agkaminski/VGAtest/README.md

# VGA test

Proof of concept VGA 640x480@60Hz video adapter. Only 80x60 text mode is
supported, up to 4 fonts (8x8 font, 256 char each.

## PCB



## Example video output
