agkaminski/VGAtest/schematic.pdf

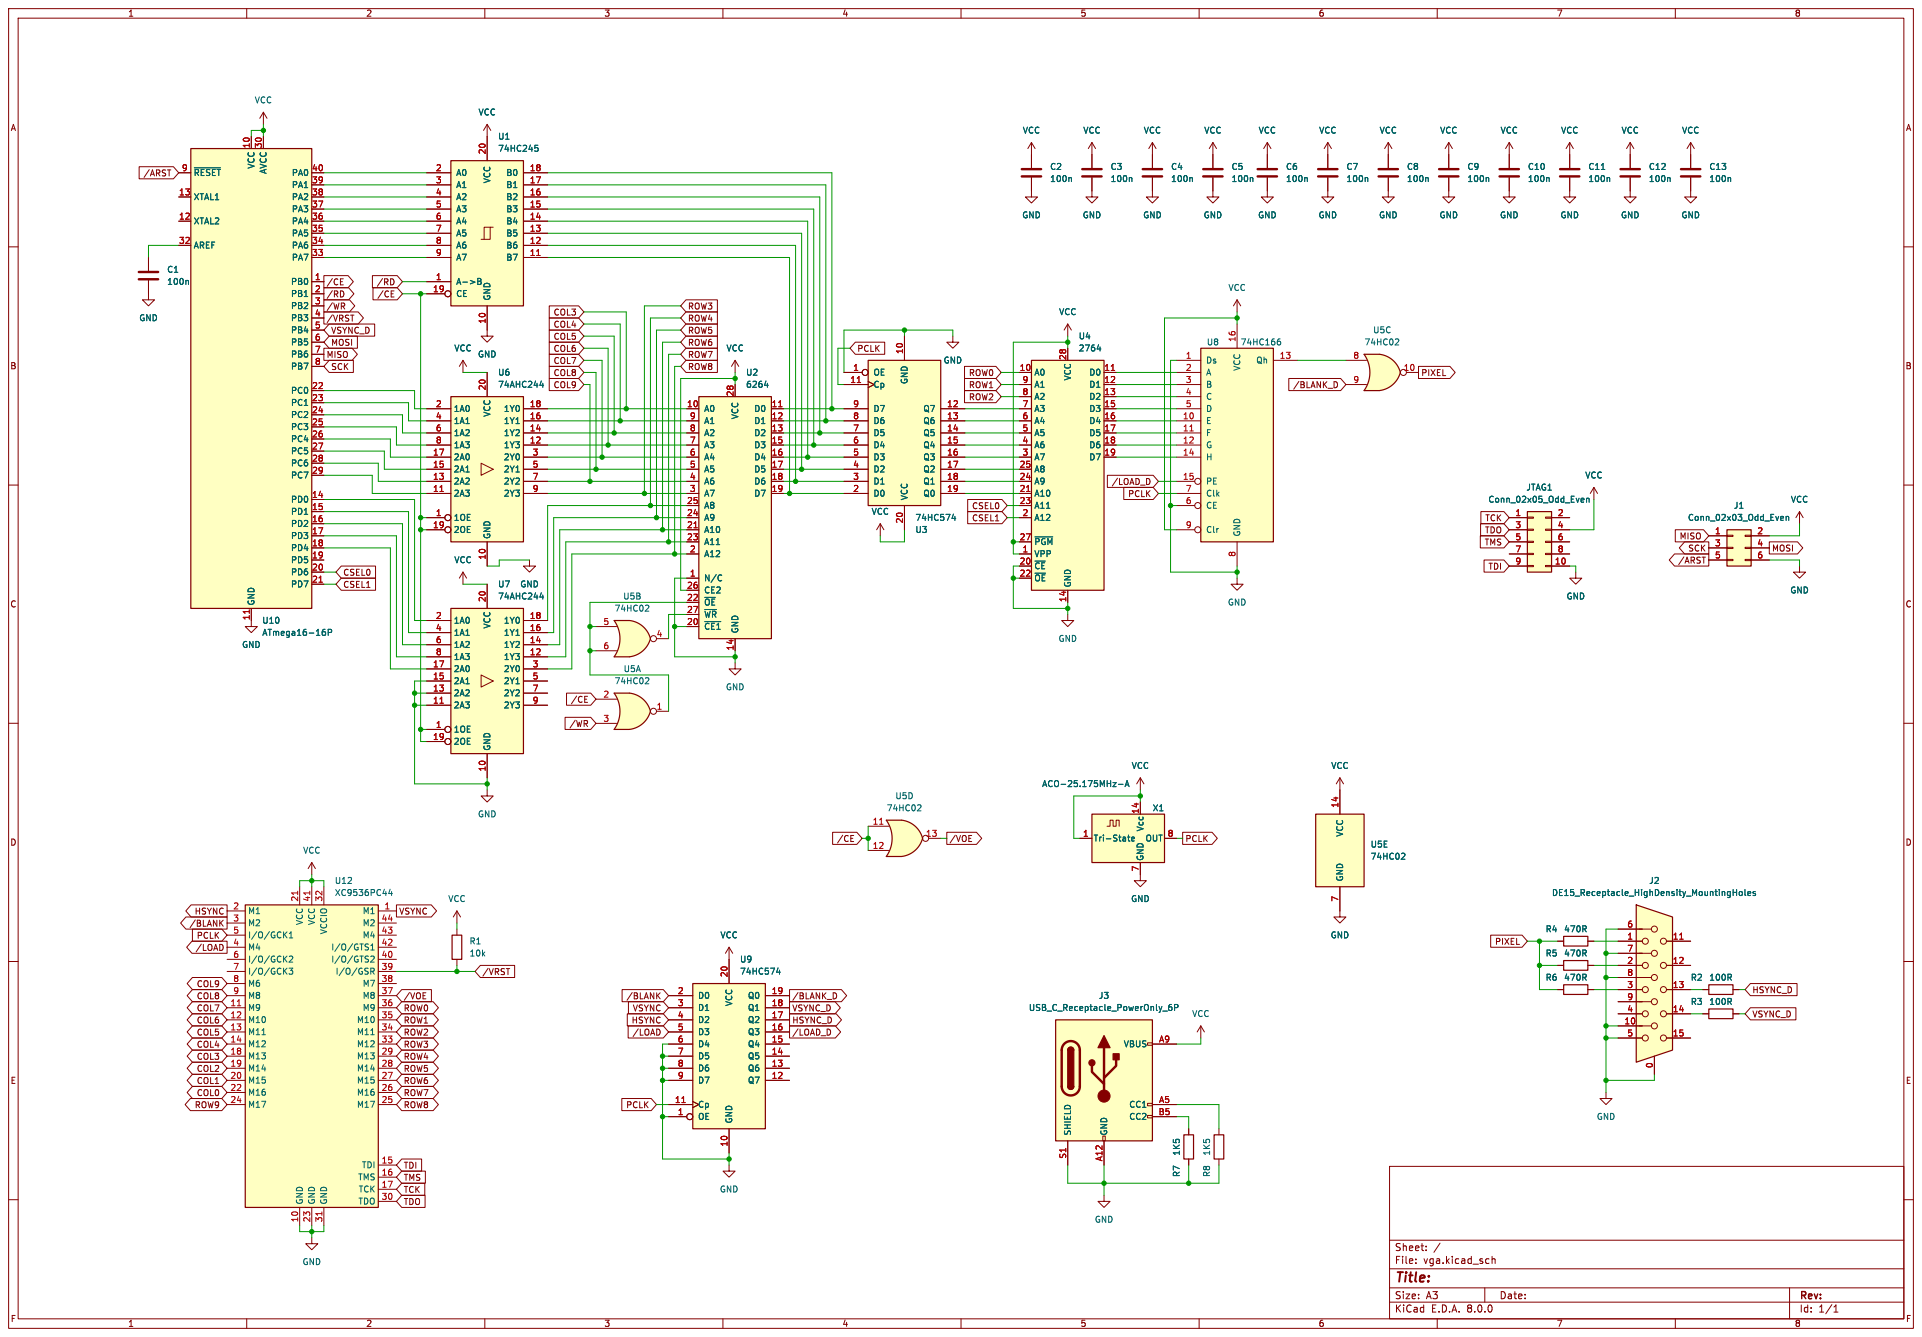
[picture p1: page 1]

Id: 1/1 Title: File: vga.kicad_sch Sheet: /
