agkaminski/VGAtest/kicad/vga.kicad_pcb

## KiCad design kicad/vga.kicad_pcb (2024-03-17)

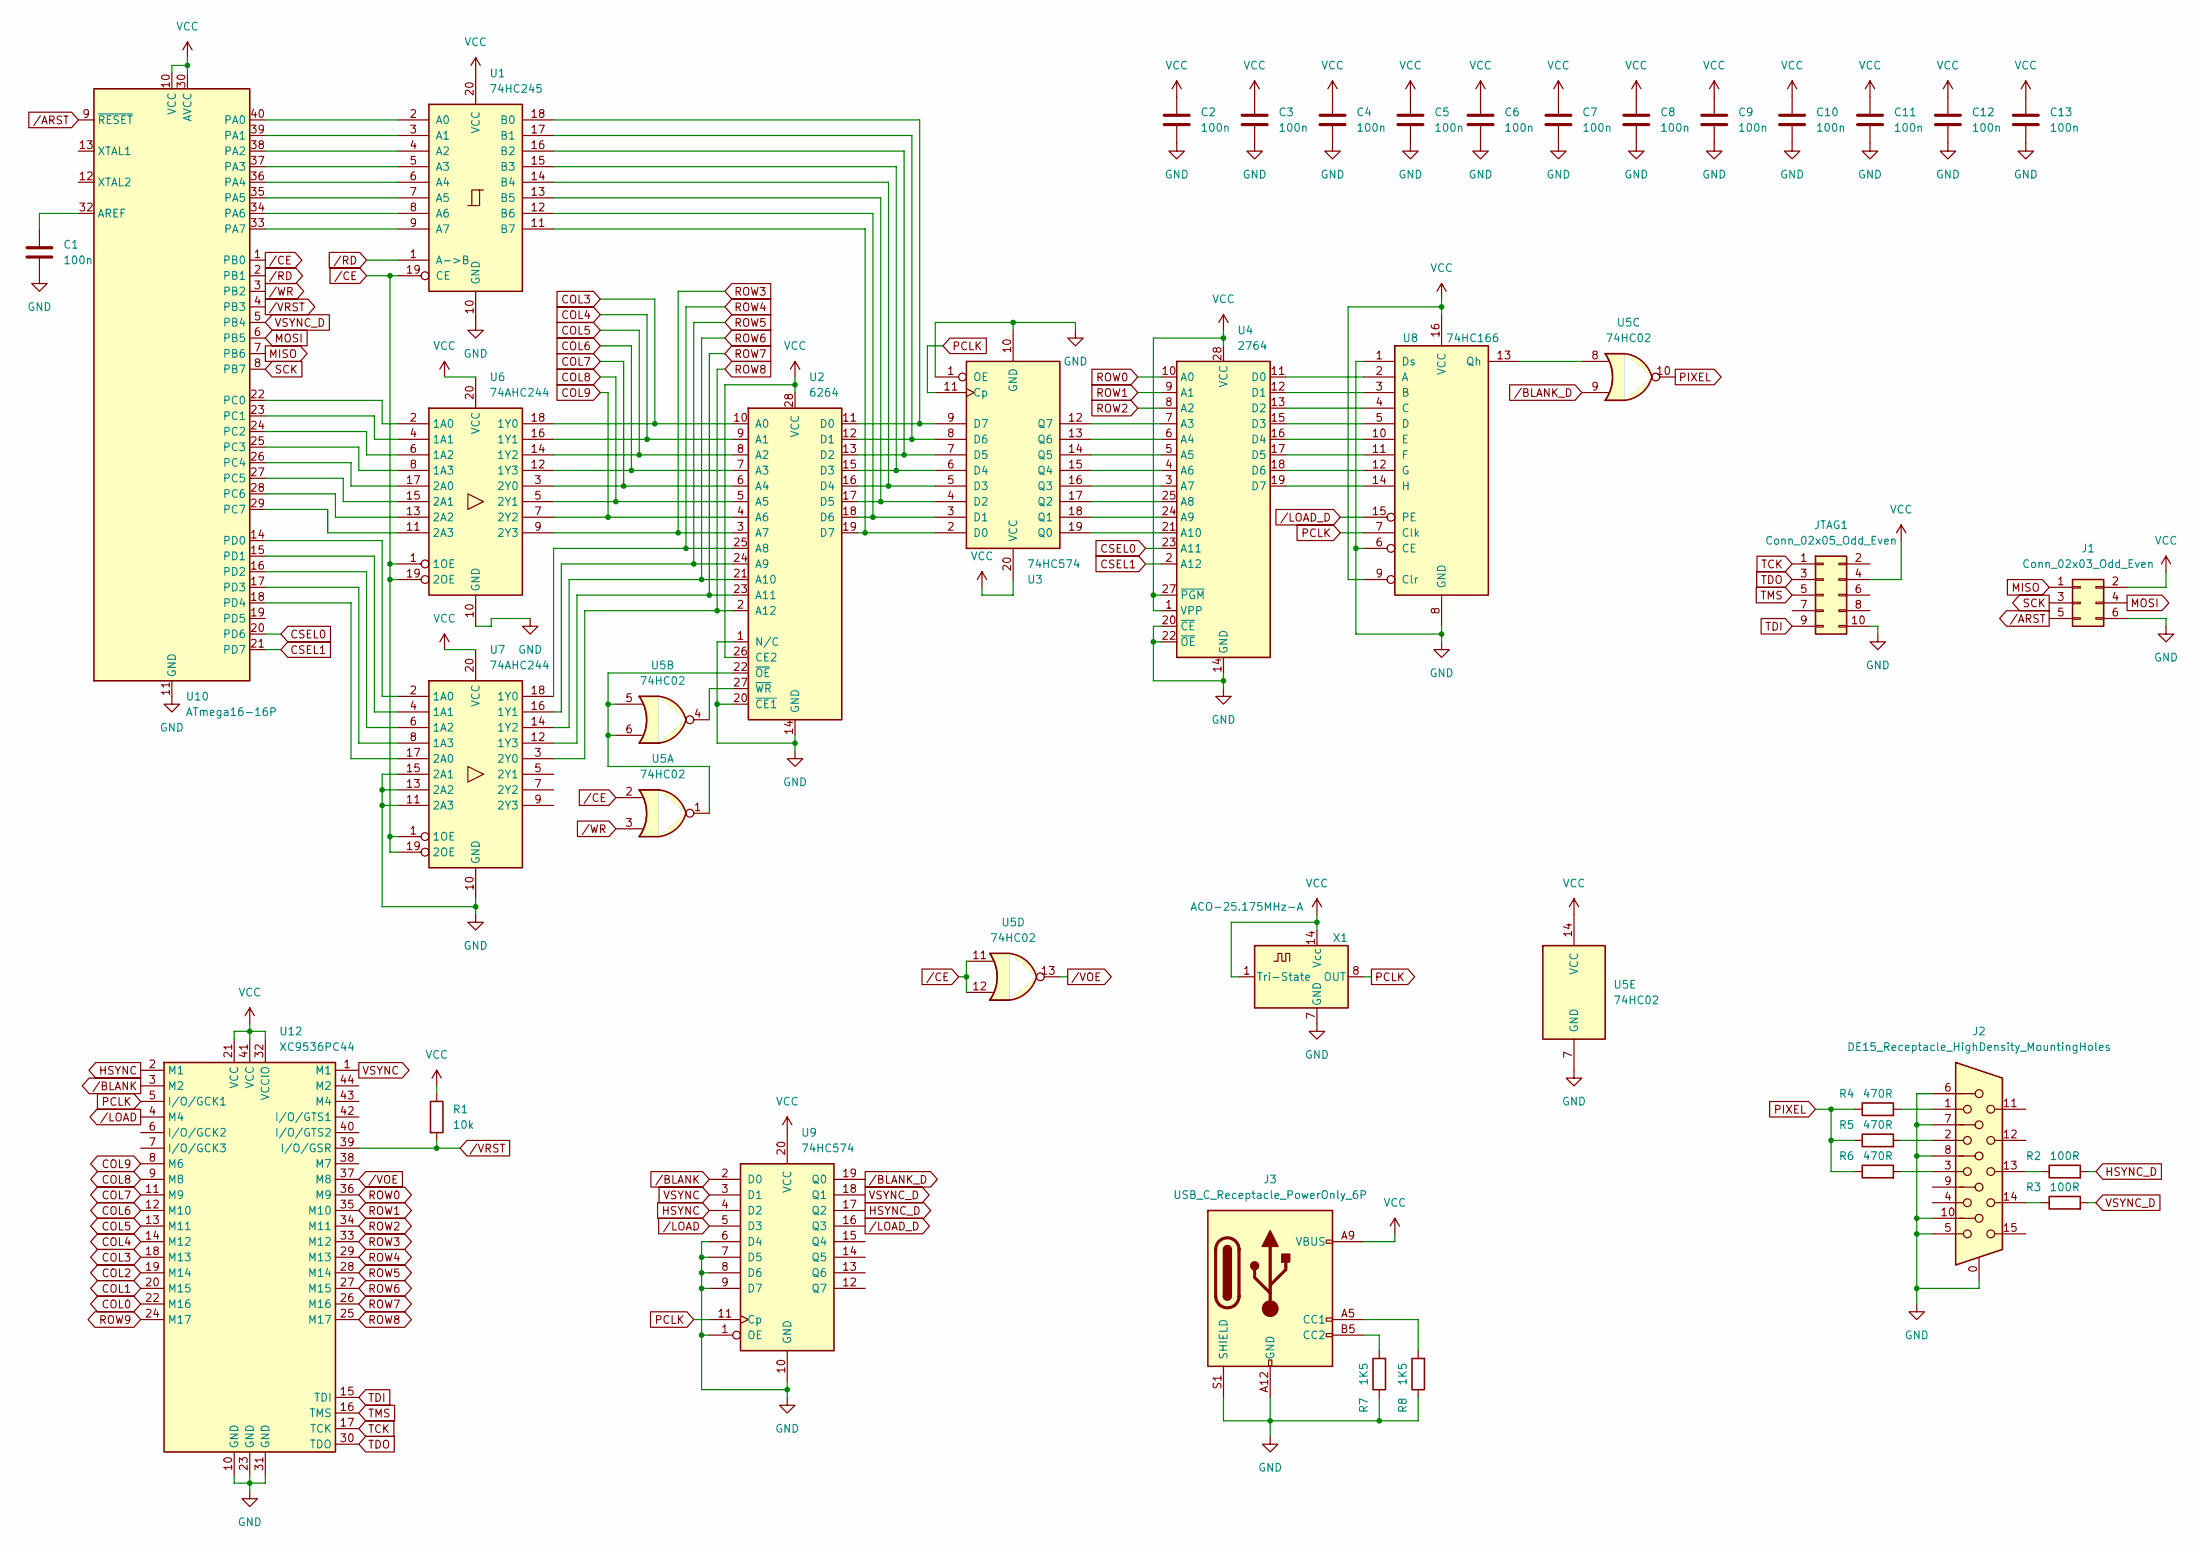
[picture p2: schematic vga.kicad_sch]

Parts:
C1, C2, C3, C4, C5, C6, C7, C8, C9, C10, C11, C12, C13: 100n; C_Disc_D5.0mm_W2.5mm_P5.00mm
J1: Conn_02x03_Odd_Even; IDC-Header_2x03_P2.54mm_Vertical
J2: DE15_Receptacle_HighDensity_MountingHoles; DSUB-15-HD_Female_Horizontal_P2.29x1.98mm_EdgePinOffset3.03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
J3: USB_C_Receptacle_PowerOnly_6P; USB_C_Receptacle_GCT_USB4135-GF-A_6P_TopMnt_Horizontal
JTAG1: Conn_02x05_Odd_Even; IDC-Header_2x05_P2.54mm_Vertical
R1: 10k; R_Axial_DIN0207_L6.3mm_D2.5mm_P10.16mm_Horizontal
R2, R3: 100R; R_Axial_DIN0207_L6.3mm_D2.5mm_P10.16mm_Horizontal
R4, R5, R6: 470R; R_Axial_DIN0207_L6.3mm_D2.5mm_P10.16mm_Horizontal
R7, R8: 1K5; R_Axial_DIN0207_L6.3mm_D2.5mm_P10.16mm_Horizontal
U1: 74HC245; DIP-20_W7.62mm
U2: 6264; DIP-28_W15.24mm
U3, U9: 74HC574; DIP-20_W7.62mm
U4: 2764; DIP-28_W15.24mm
U5: 74HC02; DIP-14_W7.62mm
U6, U7: 74AHC244; DIP-20_W7.62mm
U8: 74HC166; DIP-16_W7.62mm
U10: ATmega16-16P; DIP-40_W15.24mm
U12: XC9536PC44; PLCC-44_THT-Socket
X1: ACO-25.175MHz-A; Oscillator_DIP-14

Connections:
COL0: U12.22 (M16)
COL1: U12.20 (M15)
COL2: U12.19 (M14)
COL3: U2.10 (A0), U6.18 (1Y0), U12.18 (M13)
COL4: U2.9 (A1), U6.16 (1Y1), U12.14 (M12)
COL5: U2.8 (A2), U6.14 (1Y2), U12.13 (M11)
COL6: U2.7 (A3), U6.12 (1Y3), U12.12 (M10)
COL7: U2.6 (A4), U6.3 (2Y0), U12.11 (M9)
COL8: U2.5 (A5), U6.5 (2Y1), U12.9 (M8)
COL9: U2.4 (A6), U6.7 (2Y2), U12.8 (M6)
CSEL0: U4.23 (A11), U10.20 (PD6)
CSEL1: U4.2 (A12), U10.21 (PD7)
GND: C1.2, C2.2, C3.2, C4.2, C5.2, C6.2, C7.2, C8.2, C9.2, C10.2, C11.2, C12.2, C13.2, J1.6, J2.0, J2.5, J2.6, J2.7, J2.8, J2.10, J3.A12 (GND), J3.B12 (GND), J3.S1 (SHIELD), JTAG1.10, R7.1, R8.1, U1.10 (GND), U2.1 (N/C), U2.14 (GND), U2.20 (~CE1), U3.1 (OE), U3.10 (GND), U4.14 (GND), U4.20 (~CE), U4.22 (~OE), U5.7 (GND), U6.10 (GND), U7.10 (GND), U7.11 (2A3), U7.13 (2A2), U7.15 (2A1), U8.1 (Ds), U8.6 (CE), U8.8 (GND), U9.1 (OE), U9.6 (D4), U9.7 (D5), U9.8 (D6), U9.9 (D7), U9.10 (GND), U10.11 (GND), U10.31 (GND), U12.10 (GND), U12.23 (GND), U12.31 (GND), X1.7 (GND)
HSYNC: U9.4 (D2), U12.2 (M1)
HSYNC_D: R2.2, U9.17 (Q2)
MISO: J1.1, U10.7 (PB6)
MOSI: J1.4, U10.6 (PB5)
unnamed: J2.1, R4.2
unnamed: J2.2, R5.2
unnamed: J2.3, R6.2
unnamed: J2.13, R2.1
unnamed: J2.14, R3.1
unnamed: J3.A5 (CC1), R8.2
unnamed: J3.B5 (CC2), R7.2
unnamed: U1.2 (A0), U10.40 (PA0)
unnamed: U1.3 (A1), U10.39 (PA1)
unnamed: U1.4 (A2), U10.38 (PA2)
unnamed: U1.5 (A3), U10.37 (PA3)
unnamed: U1.6 (A4), U10.36 (PA4)
unnamed: U1.7 (A5), U10.35 (PA5)
unnamed: U1.8 (A6), U10.34 (PA6)
unnamed: U1.9 (A7), U10.33 (PA7)
unnamed: U1.18 (B0), U2.11 (D0), U3.9 (D7)
unnamed: U1.17 (B1), U2.12 (D1), U3.8 (D6)
unnamed: U1.16 (B2), U2.13 (D2), U3.7 (D5)
unnamed: U1.15 (B3), U2.15 (D3), U3.6 (D4)
unnamed: U1.14 (B4), U2.16 (D4), U3.5 (D3)
unnamed: U1.13 (B5), U2.17 (D5), U3.4 (D2)
unnamed: U1.12 (B6), U2.18 (D6), U3.3 (D1)
unnamed: U1.11 (B7), U2.19 (D7), U3.2 (D0)
unnamed: U2.22 (~OE), U5.1, U5.5, U5.6
unnamed: U2.27 (~WR), U5.4
unnamed: U3.19 (Q0), U4.21 (A10)
unnamed: U3.18 (Q1), U4.24 (A9)
unnamed: U3.17 (Q2), U4.25 (A8)
unnamed: U3.16 (Q3), U4.3 (A7)
unnamed: U3.15 (Q4), U4.4 (A6)
unnamed: U3.14 (Q5), U4.5 (A5)
unnamed: U3.13 (Q6), U4.6 (A4)
unnamed: U3.12 (Q7), U4.7 (A3)
unnamed: U4.11 (D0), U8.2 (A)
unnamed: U4.12 (D1), U8.3 (B)
unnamed: U4.13 (D2), U8.4 (C)
unnamed: U4.15 (D3), U8.5 (D)
unnamed: U4.16 (D4), U8.10 (E)
unnamed: U4.17 (D5), U8.11 (F)
unnamed: U4.18 (D6), U8.12 (G)
unnamed: U4.19 (D7), U8.14 (H)
unnamed: U5.8, U8.13 (Qh)
unnamed: C1.1, U10.32 (AREF)
unnamed: U6.2 (1A0), U10.22 (PC0)
unnamed: U6.4 (1A1), U10.23 (PC1)
unnamed: U6.6 (1A2), U10.24 (PC2)
unnamed: U6.8 (1A3), U10.25 (PC3)
unnamed: U6.17 (2A0), U10.26 (PC4)
unnamed: U6.15 (2A1), U10.27 (PC5)
unnamed: U6.13 (2A2), U10.28 (PC6)
unnamed: U6.11 (2A3), U10.29 (PC7)
unnamed: U7.2 (1A0), U10.14 (PD0)
unnamed: U7.4 (1A1), U10.15 (PD1)
unnamed: U7.6 (1A2), U10.16 (PD2)
unnamed: U7.8 (1A3), U10.17 (PD3)
unnamed: U7.17 (2A0), U10.18 (PD4)
PCLK: U3.11 (Cp), U8.7 (Clk), U9.11 (Cp), U12.5 (I/O/GCK1), X1.8 (OUT)
PIXEL: R4.1, R5.1, R6.1, U5.10
ROW0: U4.10 (A0), U12.36 (M9)
ROW1: U4.9 (A1), U12.35 (M10)
ROW2: U4.8 (A2), U12.34 (M11)
ROW3: U2.3 (A7), U6.9 (2Y3), U12.33 (M12)
ROW4: U2.25 (A8), U7.18 (1Y0), U12.29 (M13)
ROW5: U2.24 (A9), U7.16 (1Y1), U12.28 (M14)
ROW6: U2.21 (A10), U7.14 (1Y2), U12.27 (M15)
ROW7: U2.23 (A11), U7.12 (1Y3), U12.26 (M16)
ROW8: U2.2 (A12), U7.3 (2Y0), U12.25 (M17)
ROW9: U12.24 (M17)
SCK: J1.3, U10.8 (PB7)
TCK: JTAG1.1, U12.17 (TCK)
TDI: JTAG1.9, U12.15 (TDI)
TDO: JTAG1.3, U12.30 (TDO)
TMS: JTAG1.5, U12.16 (TMS)
VCC: C2.1, C3.1, C4.1, C5.1, C6.1, C7.1, C8.1, C9.1, C10.1, C11.1, C12.1, C13.1, J1.2, J3.A9 (VBUS), J3.B9 (VBUS), JTAG1.4, R1.1, U1.20 (VCC), U2.26 (CE2), U2.28 (VCC), U3.20 (VCC), U4.1 (VPP), U4.27 (~PGM), U4.28 (VCC), U5.14 (VCC), U6.20 (VCC), U7.20 (VCC), U8.9 (Clr), U8.16 (VCC), U9.20 (VCC), U10.10 (VCC), U10.30 (AVCC), U12.21 (VCC), U12.32 (VCCIO), U12.41 (VCC), X1.1 (Tri-State), X1.14 (Vcc)
VSYNC: U9.3 (D1), U12.1 (M1)
VSYNC_D: R3.2, U9.18 (Q1), U10.5 (PB4)
/ARST: J1.5, U10.9 (~RESET)
/BLANK: U9.2 (D0), U12.3 (M2)
/BLANK_D: U5.9, U9.19 (Q0)
/CE: U1.19 (CE), U5.2, U5.11, U5.12, U6.1 (1OE), U6.19 (2OE), U7.1 (1OE), U7.19 (2OE), U10.1 (PB0)
/LOAD: U9.5 (D3), U12.4 (M4)
/LOAD_D: U8.15 (PE), U9.16 (Q3)
/RD: U1.1 (A->B), U10.2 (PB1)
/VOE: U5.13, U12.37 (M8)
/VRST: R1.2, U10.4 (PB3), U12.39 (I/O/GSR)
/WR: U5.3, U10.3 (PB2)

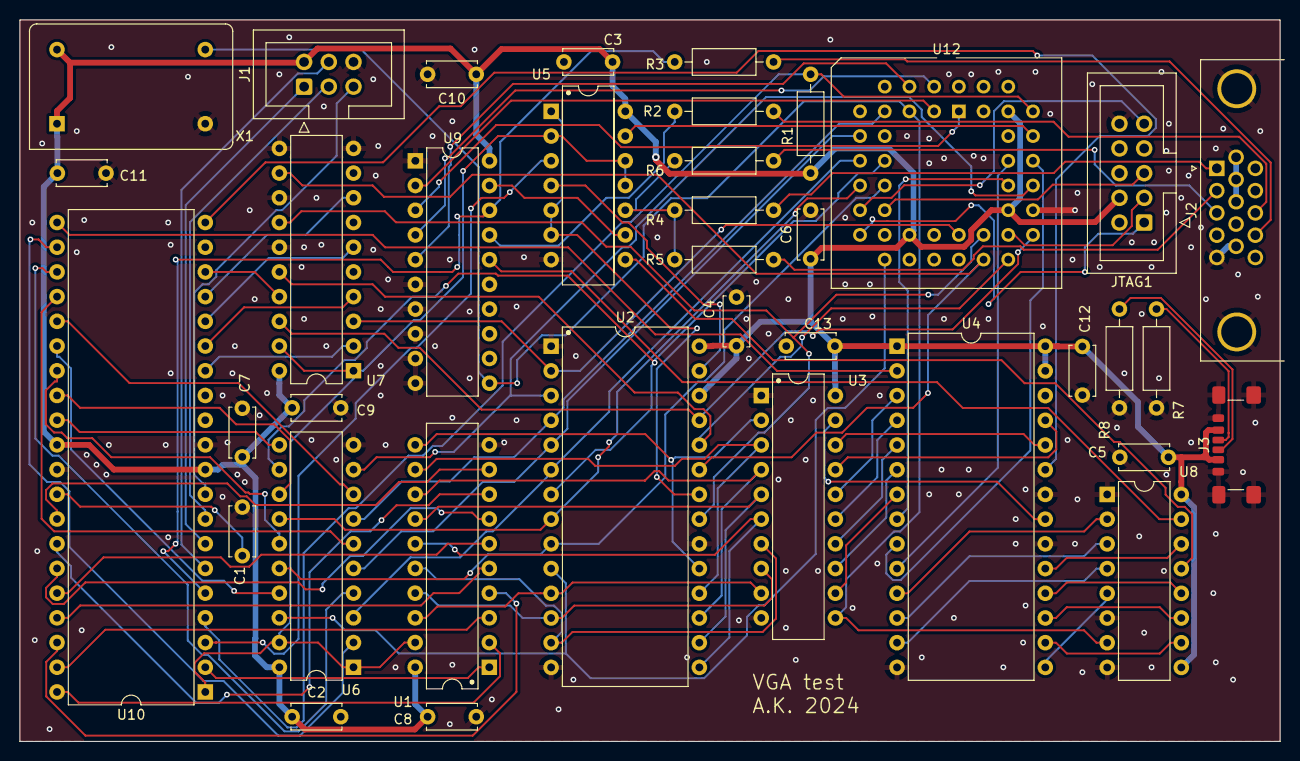
[picture p3: board vga.kicad_pcb from above]

Board: 2 copper layers, 129.5 x 74.2 mm, 37 parts (0 on the bottom side), 99 nets.
