agkaminski/VGAtest/avr/text_gen.c

#include <stdint.h>

#include <avr/io.h>
#include <util/delay.h>
#include <avr/pgmspace.h>


static const uint16_t string[] PROGMEM = {
	0x6f4d, 0x206a, 0x7473, 0x7261, 0x2079, 0x6f74, 0x6620, 0x6e61, 
	0x7461, 0x6b79, 0x7720, 0x6465, 0x616b, 0x7372, 0x7774, 0x2e61, 
	0x5020, 0x6c6f, 0x6d20, 0x6569, 0x7a73, 0x616b, 0x696e, 0x2061, 
	0x617a, 0x656a, 0x6162, 0x656e, 0x7720, 0x6465, 0x616b, 0x696d, 
	0x6e20, 0x6a61, 0x6f67, 0x7372, 0x657a, 0x202e, 0x730a, 0x6572, 
	0x6e64, 0x6f69, 0x7220, 0x7a61, 0x7720, 0x6d20, 0x6569, 0x6973, 
	0x6361, 0x2075, 0x746b, 0x736f, 0x7720, 0x6564, 0x6e70, 0x6569, 
	0x7720, 0x6c20, 0x7a65, 0x6361, 0x2079, 0x616e, 0x7a20, 0x6569, 
	0x696d, 0x6820, 0x6361, 0x797a, 0x206b, 0x7a63, 0x2079, 0x6f6b, 
	0x7774, 0x6369, 0x2065, 0x0a69, 0x7274, 0x657a, 0x6162, 0x7720, 
	0x6379, 0x6169, 0x6167, 0x2063, 0x2077, 0x7a73, 0x6970, 0x6174, 
	0x756c, 0x6220, 0x206f, 0x616d, 0x616a, 0x7a20, 0x6461, 0x697a, 
	0x726f, 0x2079, 0x616e, 0x6b20, 0x6e6f, 0x7563, 0x202e, 0x2057, 
	0x7773, 0x696f, 0x206d, 0x3232, 0x6c20, 0x7465, 0x696e, 0x206d, 
	0x797a, 0x6963, 0x0a75, 0x756a, 0x207a, 0x207a, 0x3031, 0x7220, 
	0x7a61, 0x2079, 0x7962, 0x656c, 0x206d, 0x616e, 0x7420, 0x6b61, 
	0x6d69, 0x7a20, 0x6261, 0x6569, 0x7567, 0x202e, 0x7954, 0x7a64, 
	0x6569, 0x206e, 0x6574, 0x756d, 0x7020, 0x736f, 0x657a, 0x6c64, 
	0x6d65, 0x6e20, 0x2061, 0x616a, 0x696b, 0x7365, 0x6c20, 0x736f, 
	0x776f, 0x0a65, 0x6162, 0x6164, 0x696e, 0x2061, 0x6f74, 0x6220, 
	0x6261, 0x2061, 0x207a, 0x6572, 0x6563, 0x6370, 0x696a, 0x6a20, 
	0x6b61, 0x6d20, 0x696e, 0x2065, 0x7974, 0x6b6c, 0x206f, 0x6f7a, 
	0x6162, 0x7a63, 0x6c79, 0x2061, 0x6f74, 0x6b20, 0x7a61, 0x6c61, 
	0x2061, 0x7562, 0x6174, 0x7320, 0x6963, 0x6761, 0x6361, 0x7820, 
	0x0a44, 0x6f62, 0x6d20, 0x7379, 0x616c, 0x616c, 0x202c, 0x657a, 
	0x7a20, 0x6f6e, 0x7577, 0x6820, 0x6b61, 0x7720, 0x6e20, 0x646f, 
	0x657a, 0x442e, 0x7572, 0x6167, 0x7020, 0x6c6f, 0x776f, 0x2061, 
	0x696d, 0x7365, 0x6b7a, 0x6e61, 0x6169, 0x7a20, 0x6a61, 0x6265, 
	0x6e61, 0x2061, 0x6557, 0x6b64, 0x7261, 0x657a, 0x0a6d, 0x6f50, 
	0x736c, 0x696b, 0x2c6d, 0x7320, 0x6977, 0x7461, 0x6d65, 0x5720, 
	0x6465, 0x616b, 0x7a72, 0x2c61, 0x5320, 0x7075, 0x7265, 0x4b20, 
	0x7261, 0x6970, 0x6d65, 0x7820, 0x2044, 0x7469, 0x2e70, 0x4320, 
	0x206f, 0x7974, 0x7a64, 0x6569, 0x206e, 0x6a6f, 0x6963, 0x6365, 
	0x7220, 0x626f, 0x2069, 0x626f, 0x616a, 0x647a, 0x700a, 0x206f, 
	0x7377, 0x797a, 0x7473, 0x696b, 0x6863, 0x6b20, 0x6f69, 0x6b73, 
	0x6361, 0x2068, 0x2077, 0x696d, 0x7365, 0x6963, 0x2c65, 0x7a20, 
	0x6265, 0x2079, 0x6b73, 0x6d6f, 0x6c70, 0x7465, 0x776f, 0x6361, 
	0x7720, 0x7a73, 0x7379, 0x6b74, 0x6569, 0x7720, 0x6465, 0x616b, 
	0x7372, 0x696b, 0x0a65, 0x7974, 0x6f67, 0x6e64, 0x6b69, 0x2e69, 
	0x4220, 0x6c79, 0x6d65, 0x6e20, 0x2061, 0x7974, 0x656c, 0x6720, 
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
};


static char getChar(size_t pos)
{
	uint16_t data = pgm_read_word(string + (pos / 2));
	return (pos & 1) ? data >> 8 : data & 0xff;
}


static void setAddr(uint16_t addr)
{
	PORTC = addr & 0xff;
	uint8_t temp = PORTD & ~0x1f;
	PORTD = temp | ((addr >> 8) & 0x1f);
}

static void setData(uint8_t data)
{
	PORTA = data;
}

static void selectROM(int sel)
{
	uint8_t temp = PORTD & ~(0x3 << 6);
	PORTD = temp | ((sel & 0x3) << 6);
}

static void writeByte(uint16_t addr, uint8_t data)
{
	setAddr(addr);
	setData(data);

	PORTB &= ~((1 << 2) | 1);

	_delay_us(100);

	PORTB |= (1 << 2) | 1;
}

static void putChar(int row, int col, char c)
{
	uint16_t addr = (row << 7) + col;
	writeByte(addr, c);
}

static void vsync(void)
{
	while (PINB & (1 << 4));
	while (!(PINB & (1 << 4)));
}

static void clear(void)
{
	for (uint16_t addr = 0; addr < 8192; addr++)
		writeByte(addr, ' ');
}

int main(void)
{
	/* Inactivate control signals */
	DDRB = 0x0f;
	PORTB = 0xff;

	/* Address bus */
	DDRC = 0xff;
	DDRD = 0xff;

	/* Data bus */
	DDRA = 0xff;

	/* Select ROM #0 */
	selectROM(0);

	/* Reset chipset */
	PORTB &= ~(1 << 3);

	/* Clear memory */
	clear();

	/* Release the kraken! */
	PORTB |= 1 << 3;

	int rom = 0;

	while (1) {
		char c;
		int pos = 0;
		int row = 0, col = 0;
		while ((c = getChar(pos++)) != '\0') {
			if (c == '\n') { row++; col = 0; continue; }

			/* Wait for vsync */
			vsync();

			putChar(row, col, c);
			if (++col >= 80) { col = 0; ++row; }
		}

		for (int i = 0; i < 8; ++i)
			_delay_ms(250);

		clear();

		if (++rom > 1) rom = 0;
		selectROM(rom);
	}

	return 0;
}
